tienlonghungson/Hands-On-Embedded-System/README.md

<div align="center"> 

# Hands on Embedded System
</div>

This repo stores source codes when I learned Embedded System at HUST.

Codes for practice classes lie in folder practice, with 3 subdirectory corresponding the 3 practice classes.

## Requirement :
- Proteus
- Keilc 5 (Keilc 4 might be most compatible)
