tienlonghungson/Hands-On-Embedded-System/ledmatrix_595/README.md

<div align="center"> 

# Led Matrix 595
</div>

Led Matrix 595
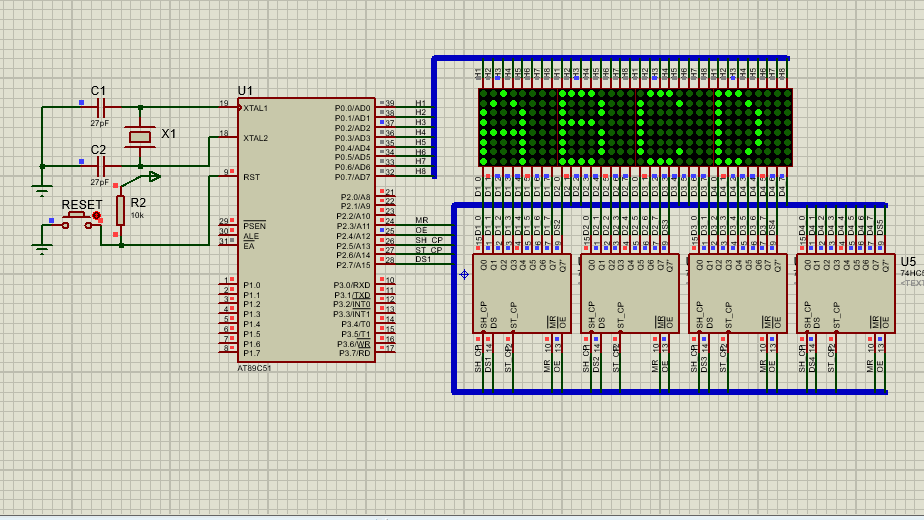
[picture p1: ledmatrix_595/ledmatrix595.png]
LEDs
