tienlonghungson/Hands-On-Embedded-System/ledmatrix/README.md

<div align="center"> 

# Led Matrix
</div>

Led Matrix
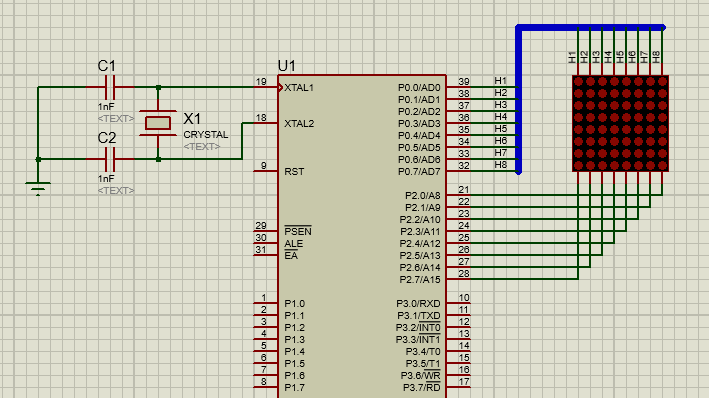
[picture p2: ledmatrix/ledmatrix.png]
LEDs
