tienlonghungson/Hands-On-Embedded-System/LED/README.md

<div align="center"> 

# LIGHT SHOW 8 LEDS
</div>

8 LED blink in bumping pattern
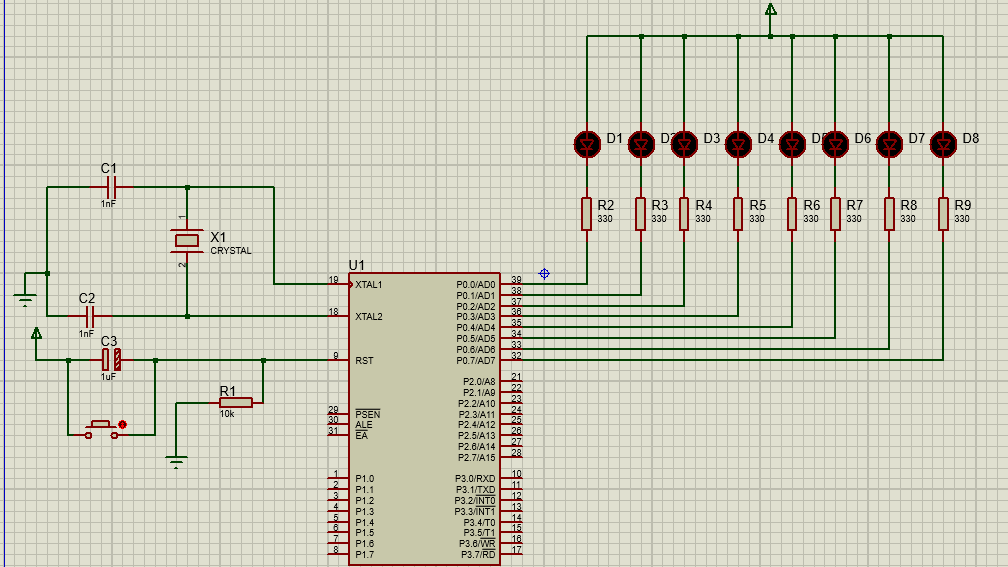
[picture p3: LED/LEDs.png]
LEDs
