tienlonghungson/Hands-On-Embedded-System/LCDKeypad/README.md

<div align="center"> 

# LCD and Keypad
</div>

The LCD's screen displays pressed button in keypad
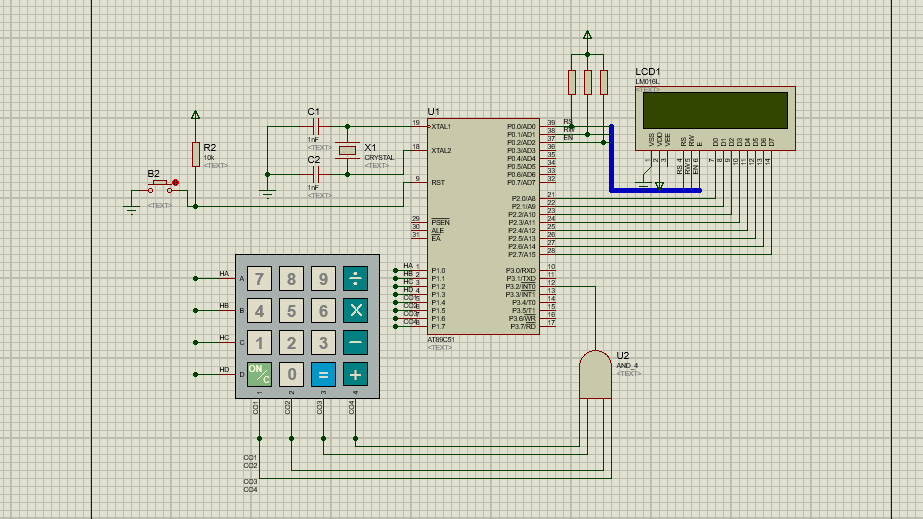
[picture p4: LCDKeypad/LCDKeypad.png]
LCDKeypad
