tienlonghungson/Hands-On-Embedded-System/HelloArduino/README.md

<div align="center"> 

# Arduino: Getting Started with pinMode
</div>
