tienlonghungson/Hands-On-Embedded-System/ArduinoInterrupt/README.md

<div align="center"> 

# Arduino Interrupt Handling
</div>
