tienlonghungson/Hands-On-Embedded-System/Alarm/README.md

<div align="center"> 

# Alarm System
</div>

This system will turn on a buzzer whenever there is a break in. The id of broken zone will be displayed in LED

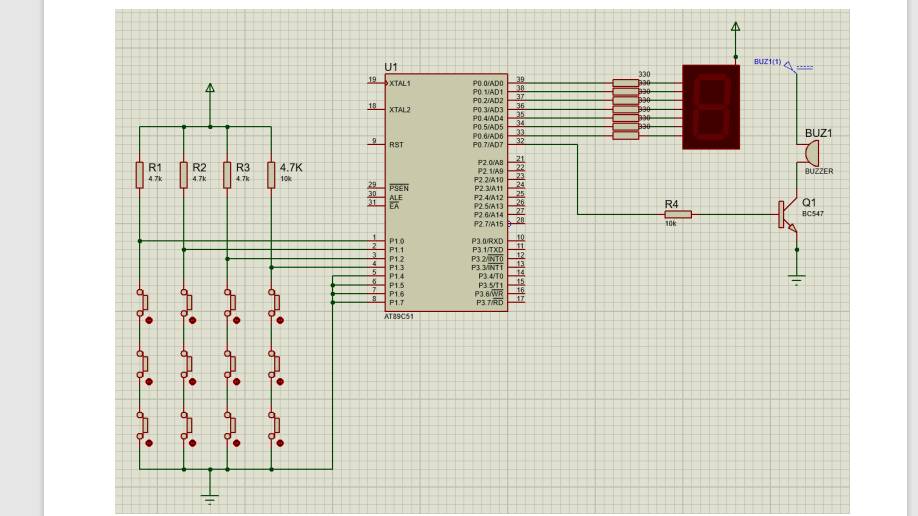
[picture p6: Alarm/Alarm.png]
Alarm
