tienlonghungson/Hands-On-Embedded-System/ExternalInterupt/README.md

<div aligh="center"> 

# Handle external interupt to display number on 7-segments led
</div>

# Description
- There are 2 buttons and 1 7-segment led on this system. Led displays a number from 0 to 9.
- The system handles the external interupt when 1 of 2 buttons is pressed.
- One button is used to increase the displayed number, while the other one is used to decrease.

# Note
- This version is hard coded
- [Here](https://github.com/tienlonghungson/Hands-On-Embedded-System/tree/main/ExtInt7seg) is a standard version.
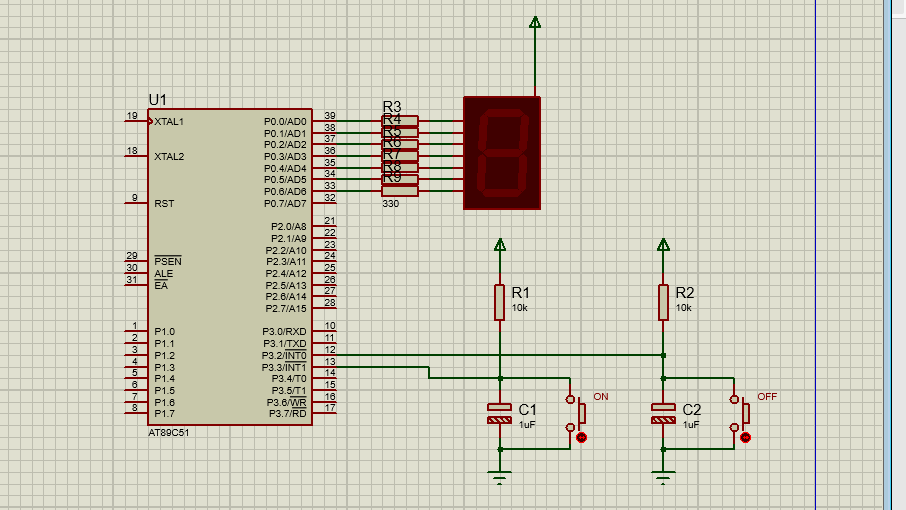
[picture p7: ExternalInterupt/extled7seg.png]
extled7seg
