tienlonghungson/Hands-On-Embedded-System/LCD/README.md

<div align="center"> 

# LCD 
</div>

LCD basic commands.
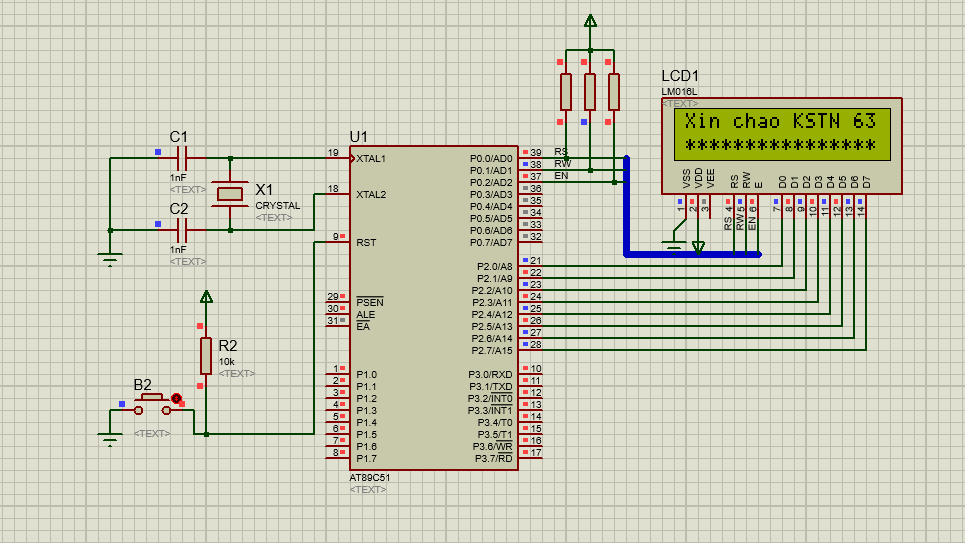
[picture p12: LCD/LCD.png]
LCD
