tienlonghungson/Hands-On-Embedded-System/Keypad/README.md

<div align="center"> 

# Keypad
</div>

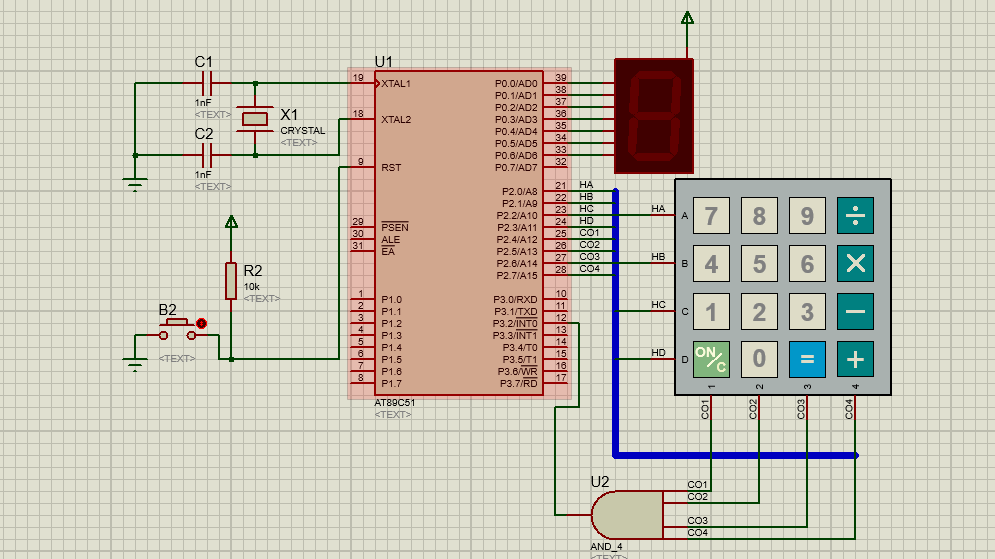
[picture p13: Keypad/Keypad.png]
Keypad
