tienlonghungson/Hands-On-Embedded-System/(list of files, drawings)

Other design files:
7segx4/7segx4.pdsprj
Alarm/Alarm.pdsprj
ArduinoInterrupt/Arduino interrupt.pdsprj
ExternalInterupt/ExtInterupt.pdsprj
ExtInt7seg/ExtInt7seg.pdsprj
HelloArduino/Hello Arduino 328/Hello Arduino 328.pdsprj
Keypad/Keypad.pdsprj
LCD/LCD.pdsprj
LCDKeypad/LCD Keypad.pdsprj
Led7thanh/7thanh.pdsprj
LED/LED.pdsprj
ledmatrix/LedMatrix.pdsprj
ledmatrix_595/LedMatrix_595.pdsprj
LedWithButton/LedWithButton.pdsprj
Practice/Practice1/Lab1_20211.pdsprj
