tienlonghungson/Hands-On-Embedded-System/(commit log)

2021-12-05 first push
    [7segx4.obj, 7segx4.pdsprj, 7thanh.pdsprj, Alarm.pdsprj, ExtInterrupt.obj, ExtInterupt.pdsprj, LCD Keypad.pdsprj, LCD.pdsprj]
2021-12-05 add gitignore
    [7segx4.obj, 7segx4.pdsprj, 7thanh.pdsprj, Alarm.pdsprj, ExtInterrupt.obj, ExtInterupt.pdsprj, LCD Keypad.pdsprj, LCD.pdsprj]
2021-12-05 remove workspace, bak, unnesseccary folders and files from git
    [7segx4.pdsprj, 7thanh.pdsprj, Alarm.pdsprj, ExtInterupt.pdsprj, LCD Keypad.pdsprj, LCD.pdsprj, LED.pdsprj, Lab1_20211.pdsprj]
2021-12-06 add led matrix and led matrix 595
    [LedMatrix.pdsprj, LedMatrix_595.pdsprj]
2021-12-29 add Arduino Sample and Practice 2
    [Hello Arduino 328.pdsprj]
2022-02-28 complete "Alarm" exercise
    [Alarm.pdsprj]
2022-02-28 handle external interrupt
    [ExtInterupt.pdsprj]
2022-02-28 Led bumping
    [LED.pdsprj]
2022-03-01 add LCD KeyPad
    [LCD Keypad.pdsprj]
2022-03-01 add LCD
    [LCD.pdsprj]
2022-03-01 add Keypad
    [Keypad.pdsprj]
2022-03-02 add led matrix
    [LedMatrix.pdsprj]
2022-03-02 add led matrix 595
    [LedMatrix_595.pdsprj]
2022-03-02 add src and circuit files
    [Arduino interrupt.pdsprj]
2022-03-07 add external interrupt for 7 segment common anod
    [ExtInt7seg.pdsprj]
